MaciekSlubowski/aquarium-refill-hose-holder/stl/1_glass_mount.stl

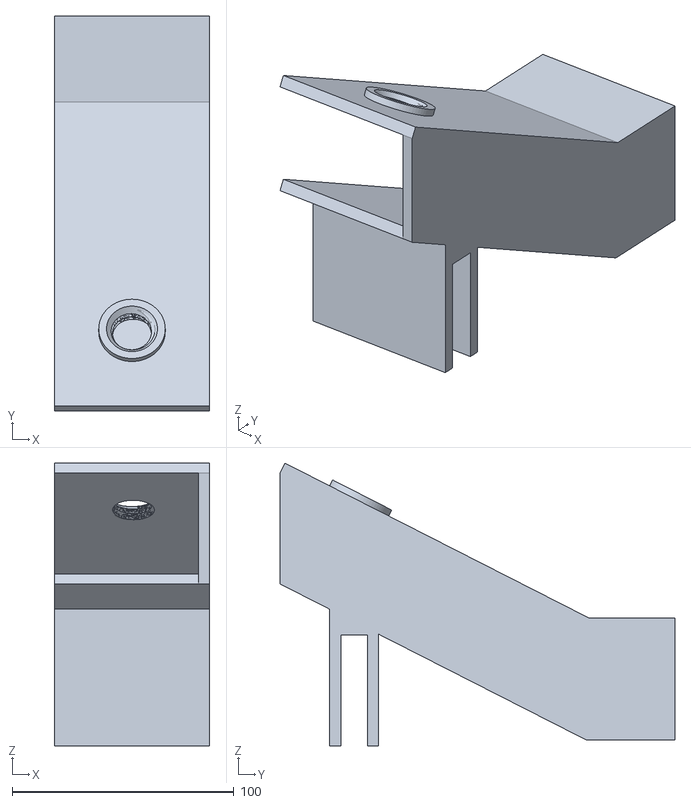
[picture p10: CAD file, 2026-11-13]
stl/1_glass_mount.stl
70.0 x 178.1 x 127.5
