MaciekSlubowski/aquarium-refill-hose-holder/stl/3_outlet_extension.stl

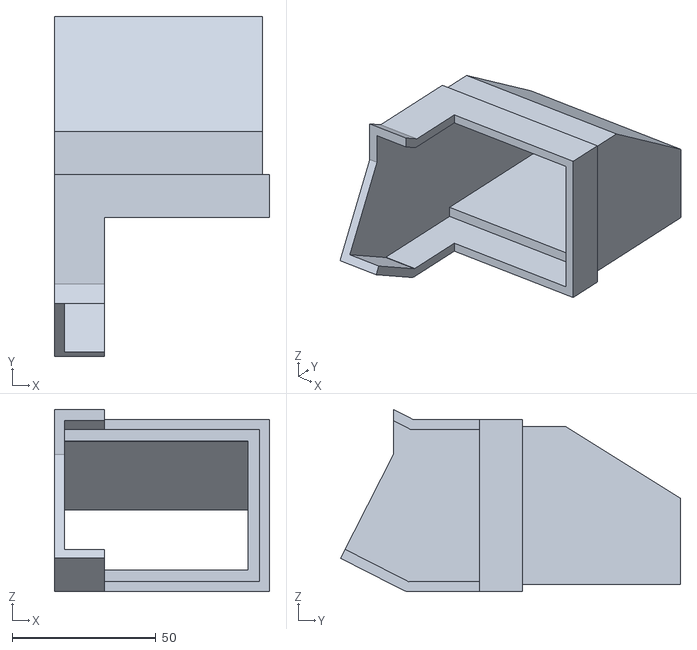
[picture p11: CAD file, 2026-11-13]
stl/3_outlet_extension.stl
75.0 x 118.4 x 63.5
