MaciekSlubowski/aquarium-refill-hose-holder/stl/2_clamp_screw.stl

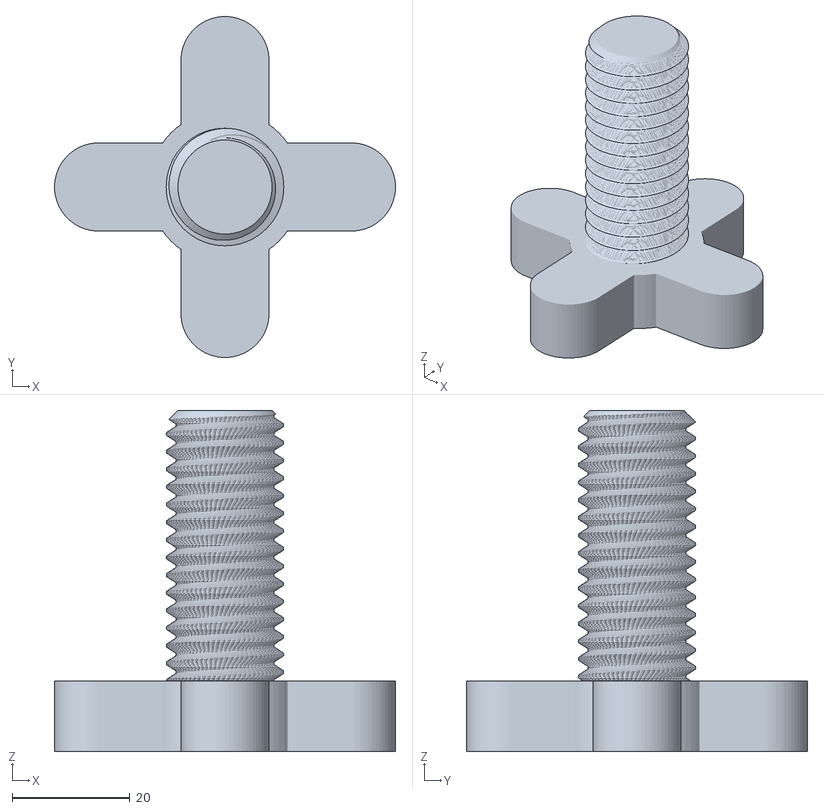
[picture p12: CAD file, 2026-11-13]
stl/2_clamp_screw.stl
58.0 x 58.0 x 58.0
