MaciekSlubowski/aquarium-refill-hose-holder/(commit log)

2026-11-13 v1.1: Self-contained part files, screw thread fixes, prototype photos
    - One self-contained .scad file per part; config.scad and lib/ removed
    - assembly.scad checks the shared values and the screw length
    - Hole and screw threads phase-locked to the seat plane
    - 45-degree lead-in chamfer on the threaded hole
    - Photos and videos of the printed prototype
    [1_glass_mount.scad, 1_glass_mount.stl, 2_clamp_screw.scad, 2_clamp_screw.stl, 3_outlet_extension.scad, 3_outlet_extension.stl, assembly.scad]
2026-11-13 Add animated previews of the prototype videos
    GitHub cannot preview the large MP4 files, so the README now shows
    looping GIFs that link to the original videos.
